Guilhermesscastro/TKL-KEYBOARD/PCB/TKL_PCB.kicad_sch

## KiCad design PCB/TKL_PCB.kicad_sch (2024-02-05)

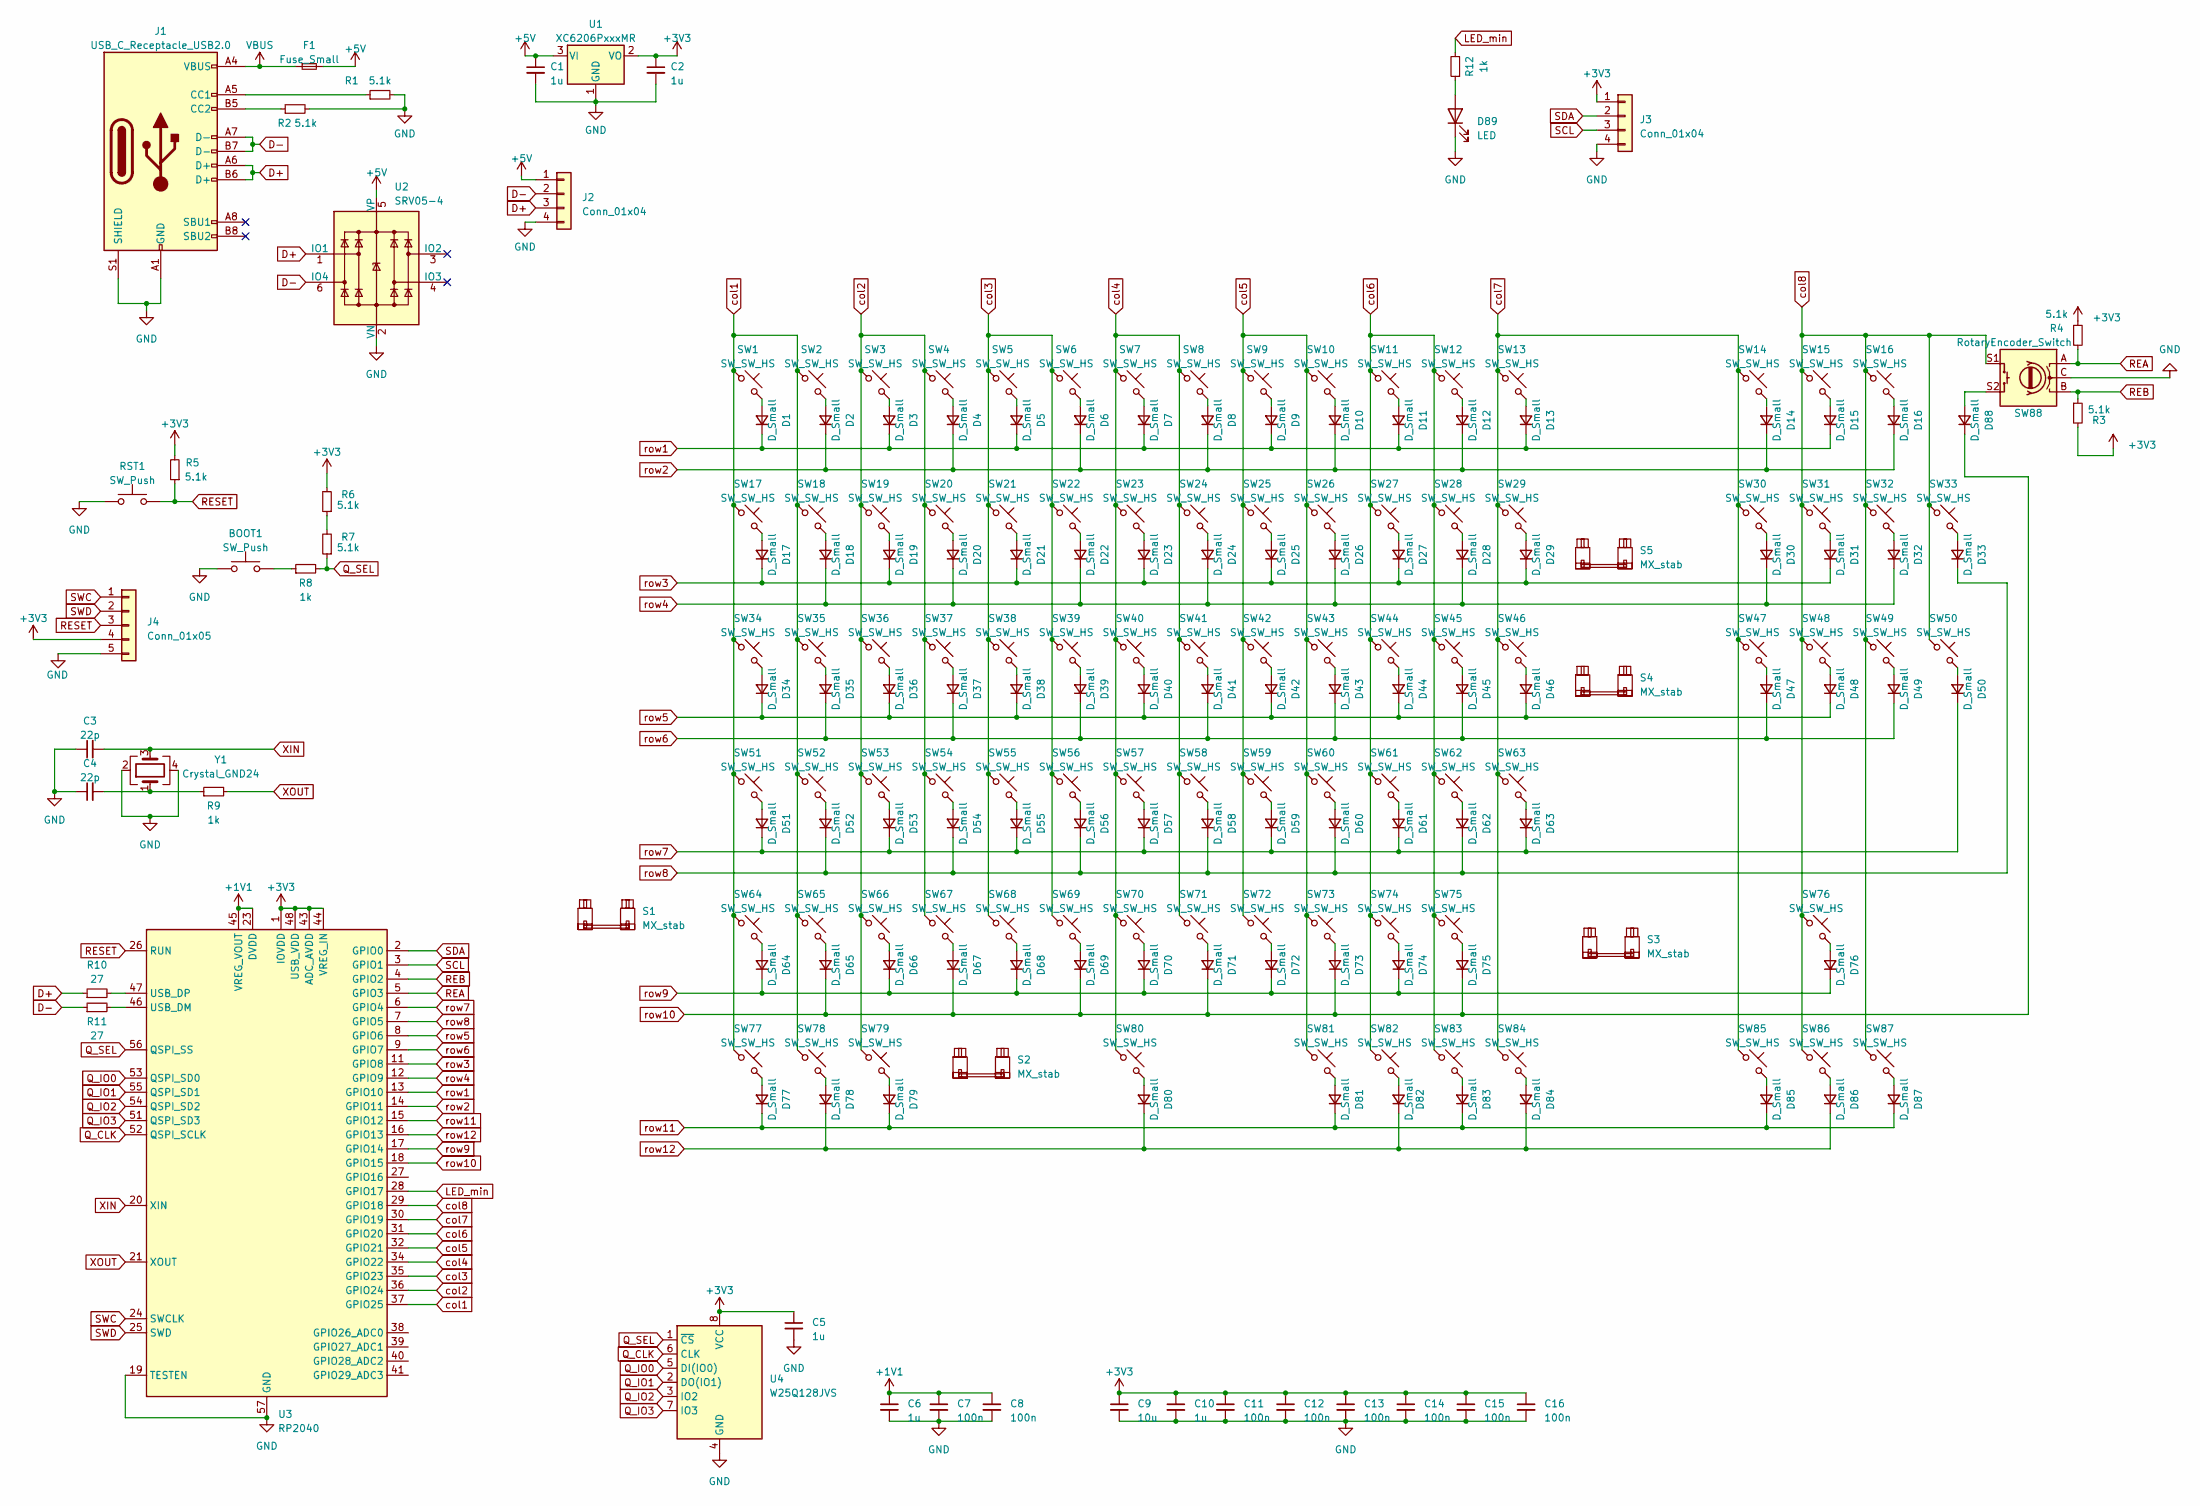
[picture p1: schematic TKL_PCB.kicad_sch]

Parts:
BOOT1: SW_Push; SW_SPST_TL3342
C1, C2, C5, C6, C10: 1u; C_0402_1005Metric
C3, C4: 22p; C_0402_1005Metric
C7, C8, C11, C12, C13, C14, C15, C16: 100n; C_0402_1005Metric
C9: 10u; C_0603_1608Metric
D1, D2, D3, D4, D5, D6, D7, D8, D9, D10, D11, D12, D13, D14, D15, D16, D17, D18, D19, D20, D21, D22, D23, D24, D25, D26, D27, D28, D29, D30, D31, D32, D33, D34, D35, D36, D37, D38, D39, D40, D41, D42, D43, D44, D45, D46, D47, D48, D49, D50, D51, D52, D53, D54, D55, D56, D57, D58, D59, D60, D61, D62, D63, D64, D65, D66, D67, D68, D69, D70, D71, D72, D73, D74, D75, D76, D77, D78, D79, D80, D81, D82, D83, D84, D85, D86, D87, D88: D_Small; D_SOD-123
D89: LED; LED_1206_3216Metric_Pad1.42x1.75mm_HandSolder
F1: Fuse_Small; Fuse_1206_3216Metric
J1: USB_C_Receptacle_USB2.0; USB_C_Receptacle_HRO_TYPE-C-31-M-12
J2: Conn_01x04; JST_SH_SM04B-SRSS-TB_1x04-1MP_P1.00mm_Horizontal
J3: Conn_01x04; PinSocket_1x04_P2.54mm_Vertical
J4: Conn_01x05; PinHeader_1x05_P2.54mm_Vertical
R1, R2, R3, R4, R5, R6, R7: 5.1k; R_0402_1005Metric
R8, R9: 1k; R_0402_1005Metric
R10, R11: 27; R_0603_1608Metric
R12: 1k; R_1206_3216Metric_Pad1.30x1.75mm_HandSolder
RST1: SW_Push; SW_SPST_TL3342
S1: MX_stab; STAB_MX_P_2.25u
S2: MX_stab; STAB_MX_P_6.25u
S3: MX_stab; STAB_MX_P_2.75u
S4: MX_stab; STAB_MX_P_ISO-ROT
S5: MX_stab; STAB_MX_P_2u
SW1, SW2, SW3, SW4, SW5, SW6, SW7, SW8, SW9, SW10, SW11, SW12, SW13, SW14, SW15, SW16, SW17, SW18, SW19, SW20, SW21, SW22, SW23, SW24, SW25, SW26, SW27, SW28, SW29, SW30, SW31, SW32, SW33, SW34, SW35, SW36, SW37, SW38, SW39, SW40, SW41, SW42, SW43, SW44, SW45, SW46, SW47, SW48, SW49, SW50, SW51, SW52, SW53, SW54, SW55, SW56, SW57, SW58, SW59, SW60, SW61, SW62, SW63, SW64, SW65, SW66, SW67, SW68, SW69, SW70, SW71, SW72, SW73, SW74, SW75, SW76, SW80, SW85, SW86, SW87: SW_SW_HS; SW_MX_HS_1u
SW77, SW78, SW79, SW81, SW82, SW83, SW84: SW_SW_HS; SW_MX_HS_1.25u
SW88: RotaryEncoder_Switch; RotaryEncoder_Alps_EC12E-Switch_Vertical_H20mm
U1: XC6206PxxxMR; SOT-23-3
U2: SRV05-4; SOT-23-6-routable
U3: RP2040; QFN-56-1EP_7x7mm_P0.4mm_EP3.2x3.2mm
U4: W25Q128JVS; SOIC-8_5.23x5.23mm_P1.27mm
Y1: Crystal_GND24; Crystal_SMD_3225-4Pin_3.2x2.5mm

Connections:
+1V1: C6.1, C7.1, C8.1, U3.23 (DVDD), U3.45 (VREG_VOUT), U3.50 (DVDD)
+3V3: C2.1, C5.1, C9.1, C10.1, C11.1, C12.1, C13.1, C14.1, C15.1, C16.1, J3.1, J4.4, R3.2, R4.1, R5.2, R6.2, U1.2 (VO), U3.1 (IOVDD), U3.10 (IOVDD), U3.22 (IOVDD), U3.33 (IOVDD), U3.42 (IOVDD), U3.43 (ADC_AVDD), U3.44 (VREG_IN), U3.48 (USB_VDD), U3.49 (IOVDD), U4.8 (VCC)
+5V: C1.1, F1.2, J2.1, U1.3 (VI), U2.5 (VP)
D+: J1.A6 (D+), J1.B6 (D+), J2.3, R10.1, U2.1 (IO1)
D-: J1.A7 (D-), J1.B7 (D-), J2.2, R11.1, U2.6 (IO4)
GND: BOOT1.1, C1.2, C2.2, C3.1, C4.1, C5.2, C6.2, C7.2, C8.2, C9.2, C10.2, C11.2, C12.2, C13.2, C14.2, C15.2, C16.2, D89.1 (K), J1.A1 (GND), J1.A12 (GND), J1.B1 (GND), J1.B12 (GND), J1.S1 (SHIELD), J2.4, J3.4, J4.5, R1.2, R2.2, RST1.1, SW88.C, U1.1 (GND), U2.2 (VN), U3.19 (TESTEN), U3.57 (GND), U4.4 (GND), Y1.2, Y1.4
LED_min: R12.2, U3.28 (GPIO17)
unnamed: BOOT1.2, R8.1
unnamed: C4.2, R9.1, Y1.1
unnamed: D1.2 (A), SW1.2
unnamed: D2.2 (A), SW2.2
unnamed: D3.2 (A), SW3.2
unnamed: D4.2 (A), SW4.2
unnamed: D5.2 (A), SW5.2
unnamed: D6.2 (A), SW6.2
unnamed: D7.2 (A), SW7.2
unnamed: D8.2 (A), SW8.2
unnamed: D9.2 (A), SW9.2
unnamed: D10.2 (A), SW10.2
unnamed: D11.2 (A), SW11.2
unnamed: D12.2 (A), SW12.2
unnamed: D13.2 (A), SW13.2
unnamed: D14.2 (A), SW14.2
unnamed: D15.2 (A), SW15.2
unnamed: D16.2 (A), SW16.2
unnamed: D17.2 (A), SW17.2
unnamed: D18.2 (A), SW18.2
unnamed: D19.2 (A), SW19.2
unnamed: D20.2 (A), SW20.2
unnamed: D21.2 (A), SW21.2
unnamed: D22.2 (A), SW22.2
unnamed: D23.2 (A), SW23.2
unnamed: D24.2 (A), SW24.2
unnamed: D25.2 (A), SW25.2
unnamed: D26.2 (A), SW26.2
unnamed: D27.2 (A), SW27.2
unnamed: D28.2 (A), SW28.2
unnamed: D29.2 (A), SW29.2
unnamed: D30.2 (A), SW30.2
unnamed: D31.2 (A), SW31.2
unnamed: D32.2 (A), SW32.2
unnamed: D33.2 (A), SW33.2
unnamed: D34.2 (A), SW34.2
unnamed: D35.2 (A), SW35.2
unnamed: D36.2 (A), SW36.2
unnamed: D37.2 (A), SW37.2
unnamed: D38.2 (A), SW38.2
unnamed: D39.2 (A), SW39.2
unnamed: D40.2 (A), SW40.2
unnamed: D41.2 (A), SW41.2
unnamed: D42.2 (A), SW42.2
unnamed: D43.2 (A), SW43.2
unnamed: D44.2 (A), SW44.2
unnamed: D45.2 (A), SW45.2
unnamed: D46.2 (A), SW46.2
unnamed: D47.2 (A), SW47.2
unnamed: D48.2 (A), SW48.2
unnamed: D49.2 (A), SW49.2
unnamed: D50.2 (A), SW50.2
unnamed: D51.2 (A), SW51.2
unnamed: D52.2 (A), SW52.2
unnamed: D53.2 (A), SW53.2
unnamed: D54.2 (A), SW54.2
unnamed: D55.2 (A), SW55.2
unnamed: D56.2 (A), SW56.2
unnamed: D57.2 (A), SW57.2
unnamed: D58.2 (A), SW58.2
unnamed: D59.2 (A), SW59.2
unnamed: D60.2 (A), SW60.2
unnamed: D61.2 (A), SW61.2
unnamed: D62.2 (A), SW62.2
unnamed: D63.2 (A), SW63.2
unnamed: D64.2 (A), SW64.2
unnamed: D65.2 (A), SW65.2
unnamed: D66.2 (A), SW66.2
unnamed: D67.2 (A), SW67.2
unnamed: D68.2 (A), SW68.2
unnamed: D69.2 (A), SW69.2
unnamed: D70.2 (A), SW70.2
unnamed: D71.2 (A), SW71.2
unnamed: D72.2 (A), SW72.2
unnamed: D73.2 (A), SW73.2
unnamed: D74.2 (A), SW74.2
unnamed: D75.2 (A), SW75.2
unnamed: D76.2 (A), SW76.2
unnamed: D77.2 (A), SW77.2
unnamed: D78.2 (A), SW78.2
unnamed: D79.2 (A), SW79.2
unnamed: D80.2 (A), SW80.2
unnamed: D81.2 (A), SW81.2
unnamed: D82.2 (A), SW82.2
unnamed: D83.2 (A), SW83.2
unnamed: D84.2 (A), SW84.2
unnamed: D85.2 (A), SW85.2
unnamed: D86.2 (A), SW86.2
unnamed: D87.2 (A), SW87.2
unnamed: D88.2 (A), SW88.S2
unnamed: D89.2 (A), R12.1
unnamed: J1.A5 (CC1), R1.1
unnamed: J1.B5 (CC2), R2.1
unnamed: R6.1, R7.2
unnamed: R10.2, U3.47 (USB_DP)
unnamed: R11.2, U3.46 (USB_DM)
Q_CLK: U3.52 (QSPI_SCLK), U4.6 (CLK)
Q_IO0: U3.53 (QSPI_SD0), U4.5 (DI(IO0))
Q_IO1: U3.55 (QSPI_SD1), U4.2 (DO(IO1))
Q_IO2: U3.54 (QSPI_SD2), U4.3 (IO2)
Q_IO3: U3.51 (QSPI_SD3), U4.7 (IO3)
Q_SEL: R7.1, R8.2, U3.56 (QSPI_SS), U4.1 (~CS)
REA: R4.2, SW88.A, U3.5 (GPIO3)
REB: R3.1, SW88.B, U3.4 (GPIO2)
RESET: J4.3, R5.1, RST1.2, U3.26 (RUN)
SCL: J3.3, U3.3 (GPIO1)
SDA: J3.2, U3.2 (GPIO0)
SWC: J4.1, U3.24 (SWCLK)
SWD: J4.2, U3.25 (SWD)
VBUS: F1.1, J1.A4 (VBUS), J1.A9 (VBUS), J1.B4 (VBUS), J1.B9 (VBUS)
XIN: C3.2, U3.20 (XIN), Y1.3
XOUT: R9.2, U3.21 (XOUT)
col1: SW1.1, SW2.1, SW17.1, SW18.1, SW34.1, SW35.1, SW51.1, SW52.1, SW64.1, SW65.1, SW77.1, SW78.1, U3.37 (GPIO25)
col2: SW3.1, SW4.1, SW19.1, SW20.1, SW36.1, SW37.1, SW53.1, SW54.1, SW66.1, SW67.1, SW79.1, U3.36 (GPIO24)
col3: SW5.1, SW6.1, SW21.1, SW22.1, SW38.1, SW39.1, SW55.1, SW56.1, SW68.1, SW69.1, U3.35 (GPIO23)
col4: SW7.1, SW8.1, SW23.1, SW24.1, SW40.1, SW41.1, SW57.1, SW58.1, SW70.1, SW71.1, SW80.1, U3.34 (GPIO22)
col5: SW9.1, SW10.1, SW25.1, SW26.1, SW42.1, SW43.1, SW59.1, SW60.1, SW72.1, SW73.1, SW81.1, U3.32 (GPIO21)
col6: SW11.1, SW12.1, SW27.1, SW28.1, SW44.1, SW45.1, SW61.1, SW62.1, SW74.1, SW75.1, SW82.1, SW83.1, U3.31 (GPIO20)
col7: SW13.1, SW14.1, SW29.1, SW30.1, SW46.1, SW47.1, SW63.1, SW84.1, SW85.1, U3.30 (GPIO19)
col8: SW15.1, SW16.1, SW31.1, SW32.1, SW33.1, SW48.1, SW49.1, SW50.1, SW76.1, SW86.1, SW87.1, SW88.S1, U3.29 (GPIO18)
row1: D1.1 (K), D3.1 (K), D5.1 (K), D7.1 (K), D9.1 (K), D11.1 (K), D13.1 (K), D15.1 (K), U3.13 (GPIO10)
row2: D2.1 (K), D4.1 (K), D6.1 (K), D8.1 (K), D10.1 (K), D12.1 (K), D14.1 (K), D16.1 (K), U3.14 (GPIO11)
row3: D17.1 (K), D19.1 (K), D21.1 (K), D23.1 (K), D25.1 (K), D27.1 (K), D29.1 (K), D31.1 (K), U3.11 (GPIO8)
row4: D18.1 (K), D20.1 (K), D22.1 (K), D24.1 (K), D26.1 (K), D28.1 (K), D30.1 (K), D32.1 (K), U3.12 (GPIO9)
row5: D34.1 (K), D36.1 (K), D38.1 (K), D40.1 (K), D42.1 (K), D44.1 (K), D46.1 (K), D48.1 (K), U3.8 (GPIO6)
row6: D35.1 (K), D37.1 (K), D39.1 (K), D41.1 (K), D43.1 (K), D45.1 (K), D47.1 (K), D49.1 (K), U3.9 (GPIO7)
row7: D50.1 (K), D51.1 (K), D53.1 (K), D55.1 (K), D57.1 (K), D59.1 (K), D61.1 (K), D63.1 (K), U3.6 (GPIO4)
row8: D33.1 (K), D52.1 (K), D54.1 (K), D56.1 (K), D58.1 (K), D60.1 (K), D62.1 (K), U3.7 (GPIO5)
row9: D64.1 (K), D66.1 (K), D68.1 (K), D70.1 (K), D72.1 (K), D74.1 (K), D76.1 (K), U3.17 (GPIO14)
row10: D65.1 (K), D67.1 (K), D69.1 (K), D71.1 (K), D73.1 (K), D75.1 (K), D88.1 (K), U3.18 (GPIO15)
row11: D77.1 (K), D79.1 (K), D81.1 (K), D83.1 (K), D85.1 (K), D87.1 (K), U3.15 (GPIO12)
row12: D78.1 (K), D80.1 (K), D82.1 (K), D84.1 (K), D86.1 (K), U3.16 (GPIO13)
