Guilhermesscastro/TKL-KEYBOARD/source/bongocat.c

#include "bsp/board.h"
#include "pico/stdlib.h"
#include "pico-ssd1306/ssd1306.h"
#include "hardware/i2c.h"
#include "bongocat.h"

// Assume 128x64 OLED display
#define WIDTH 128
#define HEIGHT 32

// Define two frames for Bongocat (you'll need to create these bitmap arrays)
const uint8_t bongocat_up[] = { 0x42, 0x4D, 0x82, 0x02, 0x00, 0x00, 0x00, 0x00, 0x00, 0x00, 0x82, 0x00, 0x00, 0x00, 0x6C, 0x00,
    0x00, 0x00, 0x80, 0x00, 0x00, 0x00, 0x20, 0x00, 0x00, 0x00, 0x01, 0x00, 0x01, 0x00, 0x00, 0x00,
    0x00, 0x00, 0x00, 0x02, 0x00, 0x00, 0x00, 0x00, 0x00, 0x00, 0x00, 0x00, 0x00, 0x00, 0x02, 0x00,
    0x00, 0x00, 0x02, 0x00, 0x00, 0x00, 0x00, 0x00, 0xFF, 0x00, 0x00, 0xFF, 0x00, 0x00, 0xFF, 0x00,
    0x00, 0x00, 0x00, 0x00, 0x00, 0xFF, 0x42, 0x47, 0x52, 0x73, 0x00, 0x00, 0x00, 0x00, 0x00, 0x00,
    0x00, 0x00, 0x00, 0x00, 0x00, 0x40, 0x00, 0x00, 0x00, 0x00, 0x00, 0x00, 0x00, 0x00, 0x00, 0x00,
    0x00, 0x40, 0x00, 0x00, 0x00, 0x00, 0x00, 0x00, 0x00, 0x00, 0x00, 0x00, 0x00, 0x40, 0x00, 0x00,
    0x00, 0x00, 0x00, 0x00, 0x00, 0x00, 0x00, 0x00, 0x00, 0x00, 0xFF, 0xFF, 0xFF, 0x00, 0x00, 0x00,
    0x00, 0x00, 0x00, 0x00, 0x00, 0x00, 0xF0, 0x00, 0x00, 0x00, 0x00, 0x00, 0x00, 0x00, 0x00, 0x00,
    0x00, 0x00, 0x00, 0x00, 0x00, 0x00, 0x0F, 0x00, 0x00, 0x00, 0x00, 0x00, 0x00, 0x00, 0x00, 0x00,
    0x00, 0x00, 0x00, 0x00, 0x00, 0x00, 0x00, 0xF0, 0x00, 0x00, 0x00, 0x00, 0x00, 0x00, 0x00, 0x00,
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
        return;  // Ignore this trigger due to debounce
    }
    
    is_tapping = true;
    tap_start_time = current_time;
    last_activity_time = current_time;
    last_tap_time = current_time;

    is_left_tap = !is_left_tap;  // Alternate between left and right taps
}

void update_bongocat_animation(ssd1306_t *disp) {
    const uint32_t interval_ms = 33;
    static uint32_t start_ms = 0;
    uint32_t current_time = board_millis();
    
    if (current_time - start_ms < interval_ms) return; // not enough time
    start_ms += interval_ms;

    
    ssd1306_clear(disp);
    if (!is_tapping) {
        if (current_time - last_activity_time < IDLE_TIMEOUT_MS) {
            // Still in active period, show paws up
            ssd1306_bmp_show_image(disp, bongocat_up, 512);
        } else {
            // Idle timeout reached, show paws down
            ssd1306_bmp_show_image(disp, bongocat_idle, 512);
        }
    } else {
        uint32_t elapsed_time = current_time - tap_start_time;
        
        if (elapsed_time < TAP_DURATION_MS) {
            if (is_left_tap) {
                ssd1306_bmp_show_image(disp, bongocat_left_tap, 512);  // Left paw tap
            } else {
                ssd1306_bmp_show_image(disp, bongocat_right_tap, 512);  // Right paw tap
            }
        } else {
            is_tapping = false;
            ssd1306_bmp_show_image(disp, bongocat_up, 512);  // Return to paws up after tap
        }
    }
    ssd1306_show(disp);
}


#if 0
//update the tapping animation based on alternating paws for each key stroke
void update_bongocat_animation(ssd1306_t *disp) {
    if (is_tapping) {
        sleep_ms(16);
        uint32_t current_time = to_ms_since_boot(get_absolute_time());
        uint32_t elapsed_time = current_time - tap_start_time;

        if (elapsed_time < TAP_DURATION_MS) {
            ssd1306_clear(disp);
            if (is_left_tap) {
                ssd1306_bmp_show_image(disp, bongocat_left_tap, 512);  // Left paw tap
            } else {
                ssd1306_bmp_show_image(disp, bongocat_right_tap, 512);  // Right paw tap
            }
            ssd1306_show(disp);
        } else {

            is_tapping = false;
            bongocat_init(disp); //default state
        }
    }
}

// Function to update animation
void update_bongocat_animation(ssd1306_t *disp) {
    if (is_animating) {
        sleep_ms(16);
        uint32_t current_time = to_ms_since_boot(get_absolute_time());
        uint32_t elapsed_time = current_time - animation_start_time;
        
        if (elapsed_time < ANIMATION_DURATION_MS / 4) {
            ssd1306_clear(disp);
            ssd1306_bmp_show_image(disp, bongocat_up, 512);  // Paws up
            ssd1306_show(disp);
        } else if (elapsed_time < ANIMATION_DURATION_MS / 2) {
            ssd1306_clear(disp);
            ssd1306_bmp_show_image(disp, bongocat_left_tap, 512);  // Left paw tap
            ssd1306_show(disp);
        } else if (elapsed_time < ANIMATION_DURATION_MS * 3 / 4) {
            ssd1306_clear(disp);
            ssd1306_bmp_show_image(disp, bongocat_right_tap, 512);  // Right paw tap
            ssd1306_show(disp);
        } else if (elapsed_time < ANIMATION_DURATION_MS) {
            ssd1306_clear(disp);
            ssd1306_bmp_show_image(disp, bongocat_up, 512);  // Paws up again
            ssd1306_show(disp);
        } else {
            is_animating = false;
            bongocat_init(disp);
        }
    }
}*/

// Function to trigger animation
/*void trigger_bongocat_animation() {
    is_animating = true;
    animation_start_time = to_ms_since_boot(get_absolute_time());
}
#endif
