Guilhermesscastro/TKL-KEYBOARD/(commit log)

2024-02-05 kicad pcb files
    [TKL_PCB-B_Cu.gbr, TKL_PCB-B_Mask.gbr, TKL_PCB-B_Paste.gbr, TKL_PCB-B_Silkscreen.gbr, TKL_PCB-Edge_Cuts.gbr, TKL_PCB-F_Cu.gbr, TKL_PCB-F_Mask.gbr, TKL_PCB-F_Paste.gbr]
2024-10-27 Big refactoring, functionality improvements and fixes. Updated README.md.
    [bongocat.c, bongocat.h, keyboard.c, keyboard.h, keyboard_v1.c, led.c]
